norly/amiga-2000-atx-adapter-pcb/amiga-2000-atx-adapter-pcb.kicad_pcb

## KiCad design amiga-2000-atx-adapter-pcb.kicad_pcb (2024-10-28)

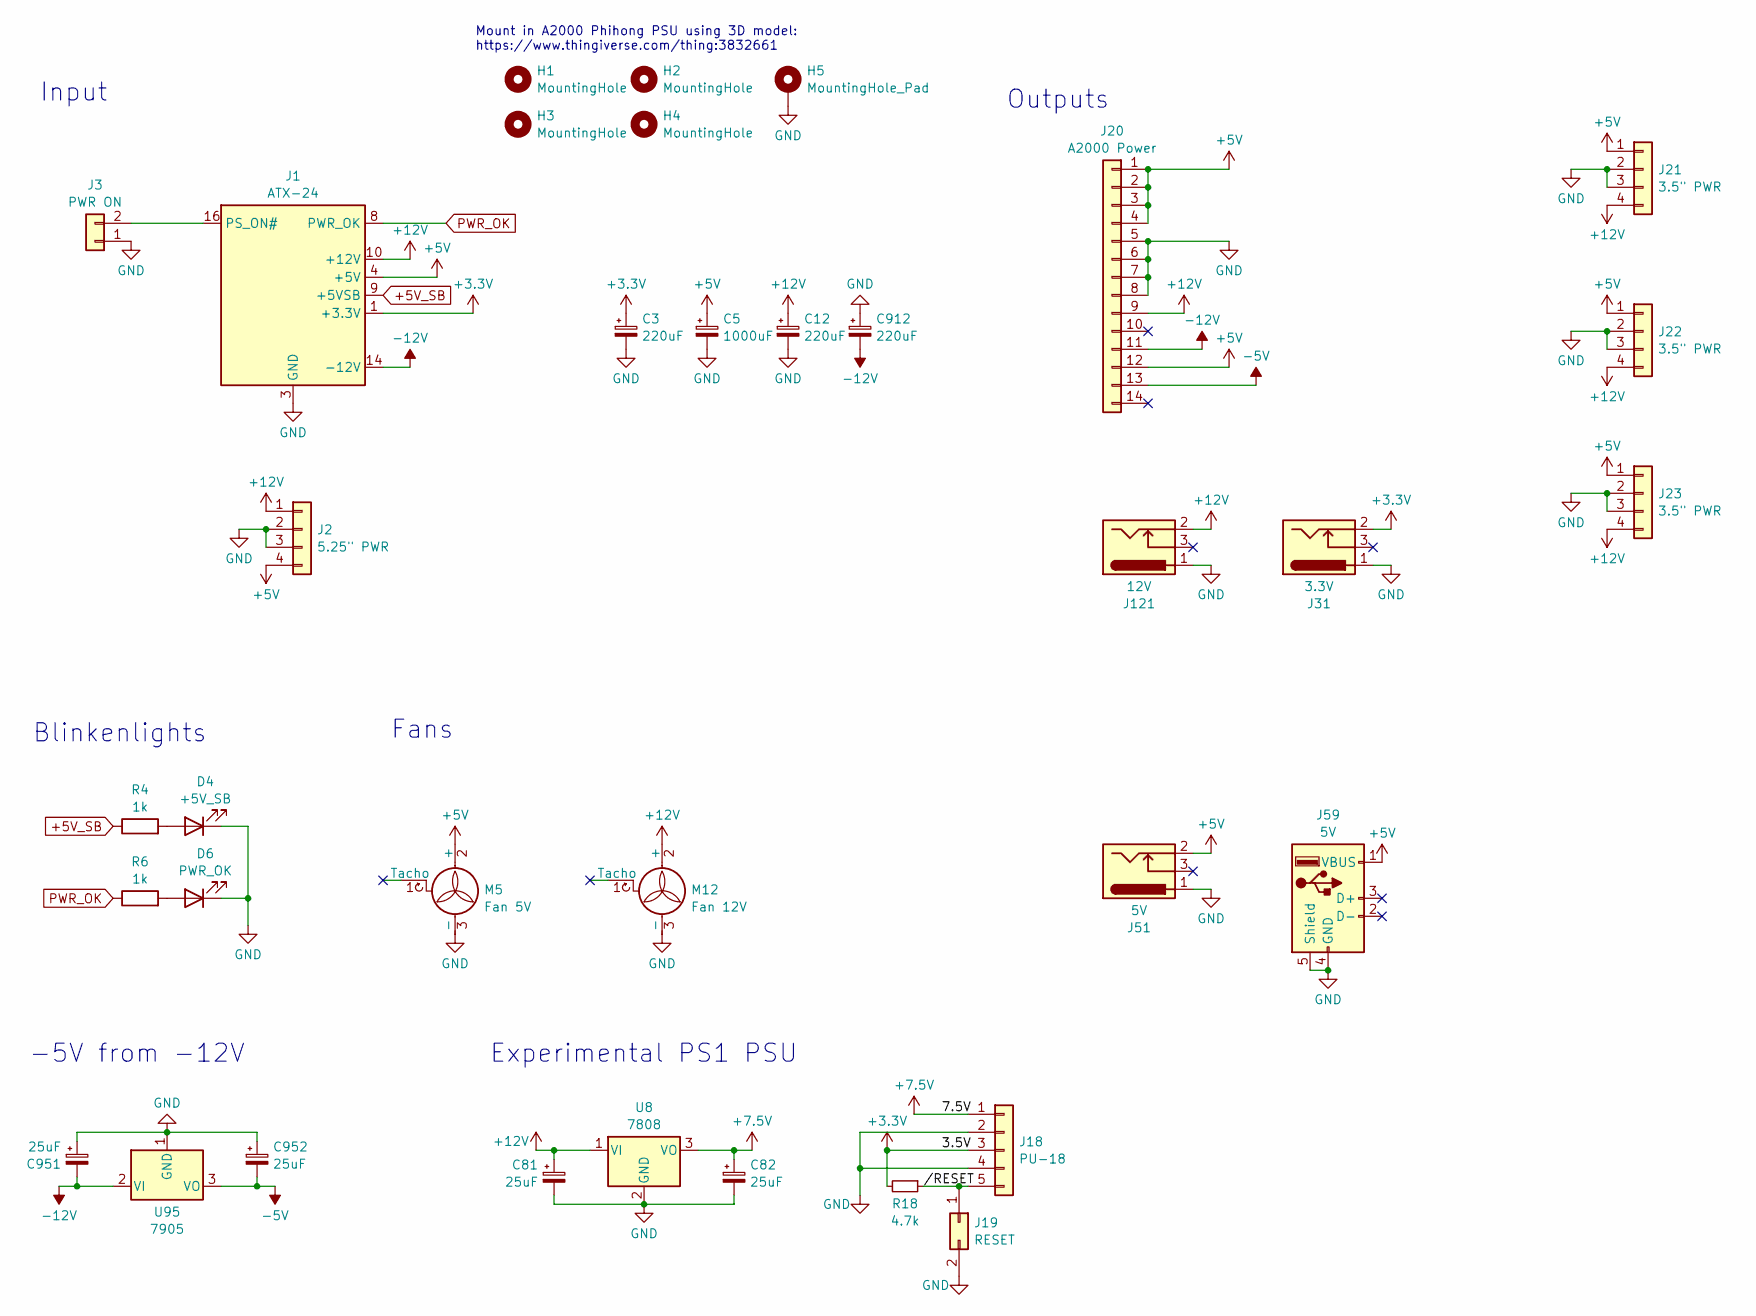
[picture p1: schematic amiga-2000-atx-adapter-pcb.kicad_sch]

Parts:
C3, C12, C912: 220uF; CP_Radial_D6.3mm_P2.50mm; LCSC C5438671
C5: 1000uF; CP_Radial_D10.0mm_P5.00mm; LCSC C5438717
C81, C82, C951, C952: 25uF; CP_Radial_D6.3mm_P2.50mm; LCSC C5438878
D4: +5V_SB; LED_D3.0mm; LCSC C6916234
D6: PWR_OK; LED_D3.0mm; LCSC C6916232
H1, H2, H3, H4: MountingHole; MountingHole_4mm
H5: MountingHole_Pad; MountingHole_3.2mm_M3_Pad
J1: ATX-24; Molex_Mini-Fit_Jr_5566-24A_2x12_P4.20mm_Vertical; LCSC C492537
J2: 5.25" PWR; TE_MATE-N-LOK_350211-1_1x04_P5.08mm_Vertical; LCSC C305826
J3: PWR ON; PinHeader_1x02_P2.54mm_Vertical; LCSC C358684
J18: PU-18; JST_EH_B5B-EH-A_1x05_P2.50mm_Vertical; LCSC C265084
J19: RESET; PinHeader_2x01_P2.54mm_Vertical
J20: A2000 Power; Molex_KK-396_A-41791-0014_1x14_P3.96mm_Vertical; LCSC C22394615
J21, J22, J23: 3.5" PWR; PinHeader_1x04_P2.54mm_Vertical; LCSC C210162
J31: 3.3V; BarrelJack_Horizontal; LCSC C22459640
J51: 5V; BarrelJack_Horizontal; LCSC C22459640
J59: 5V; USB_A_CONNFLY_DS1095-WNR0; LCSC C503996
J121: 12V; BarrelJack_Horizontal; LCSC C22459640
M5: Fan 5V; FanPinHeader_1x03_P2.54mm_Vertical; LCSC C843332
M12: Fan 12V; FanPinHeader_1x03_P2.54mm_Vertical; LCSC C843332
R4, R6: 1k; R_Axial_DIN0207_L6.3mm_D2.5mm_P7.62mm_Horizontal; LCSC C513706
R18: 4.7k; R_0603_1608Metric_Pad0.98x0.95mm_HandSolder
U8: 7808; TO-263-3_TabPin2; LCSC C7432228
U95: 7905; TO-263-3_TabPin2; LCSC C28684

Connections:
+3.3V: C3.1, J1.1 (+3.3V), J1.2 (+3.3V), J1.12 (+3.3V), J1.13 (+3.3V), J18.3, J31.2, R18.2
+5V: C5.1, J1.4 (+5V), J1.6 (+5V), J1.21 (+5V), J1.22 (+5V), J1.23 (+5V), J2.4, J20.1, J20.2, J20.3, J20.4, J20.12, J21.1, J22.1, J23.1, J51.2, J59.1 (VBUS), M5.2 (+)
+5V_SB: J1.9 (+5VSB), R4.1
+7.5V: C82.1, J18.1, U8.3 (VO)
+12V: C12.1, C81.1, J1.10 (+12V), J1.11 (+12V), J2.1, J20.9, J21.4, J22.4, J23.4, J121.2, M12.2 (+), U8.1 (VI)
-5V: C952.2, J20.13, U95.3 (VO)
-12V: C912.2, C951.2, J1.14 (-12V), J20.11, U95.2 (VI)
//RESET: J18.5, J19.1, R18.1
GND: C3.2, C5.2, C12.2, C81.2, C82.2, C912.1, C951.1, C952.1, D4.1 (K), D6.1 (K), H5.1, J1.3 (GND), J1.5 (GND), J1.7 (GND), J1.15 (GND), J1.17 (GND), J1.18 (GND), J1.19 (GND), J1.24 (GND), J2.2, J2.3, J3.1, J18.2, J18.4, J19.2, J20.5, J20.6, J20.7, J20.8, J21.2, J21.3, J22.2, J22.3, J23.2, J23.3, J31.1, J51.1, J59.4 (GND), J59.5 (Shield), J121.1, M5.3 (-), M12.3 (-), U8.2 (GND), U95.1 (GND)
unnamed: D4.2 (A), R4.2
unnamed: D6.2 (A), R6.2
unnamed: J1.16 (PS_ON#), J3.2
PWR_OK: J1.8 (PWR_OK), R6.1

Notes on the sheet:
Input
-5V from -12V
Fans
Mount in A2000 Phihong PSU using 3D model: https://www.thingiverse.com/thing:3832661
Experimental PS1 PSU
Blinkenlights
Outputs

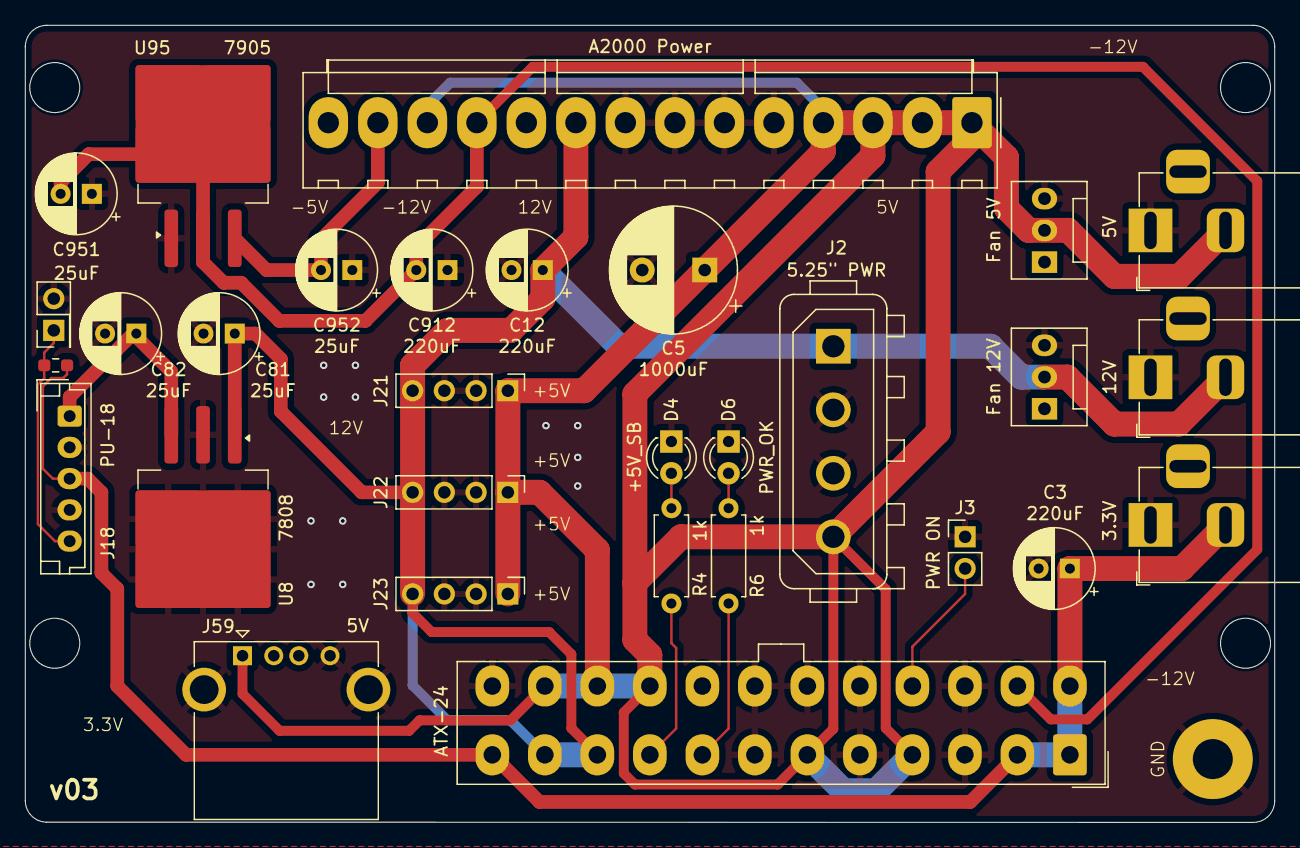
[picture p2: board amiga-2000-atx-adapter-pcb.kicad_pcb from above]

Board: 2 copper layers, 99.9 x 63.8 mm, 35 parts (0 on the bottom side), 13 nets.
