norly/amiga-2000-atx-adapter-pcb/(commit log)

2024-10-08 v02: Add ground pad
    [amiga-2000-atx-adapter-pcb.kicad_pcb, amiga-2000-atx-adapter-pcb.kicad_sch]
2024-10-28 v03: Add PS1 reset switch, remove one 3.5" connector
    The 3.5" power connectors were spaced too close together.
    [amiga-2000-atx-adapter-pcb.kicad_pcb, amiga-2000-atx-adapter-pcb.kicad_sch]
